xtrx-sdr/xtrx-adapters/PCIex2 frontend/Project Outputs/Pics/TOP_Full.png

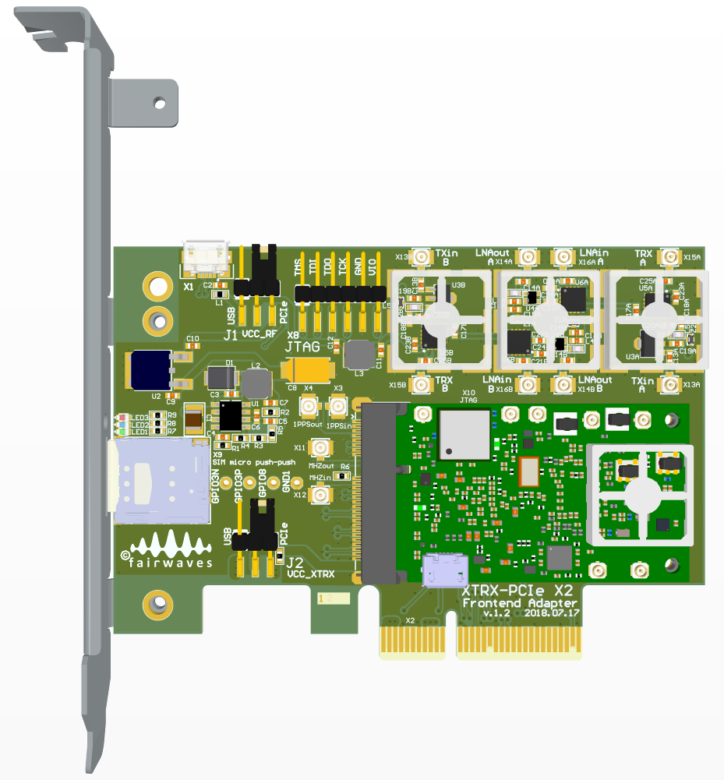
PCIex2 frontend/Project Outputs/Pics/TOP_Full.png
