xtrx-sdr/xtrx-adapters/README.md

* USB 3 Adapter with Aluminum Enclosure, v2.1
* PCIe x2 + Front End Adapter, v1.3
