xtrx-sdr/xtrx-adapters/PCIex2 frontend/Project Outputs/Pics/Layer Stack.png

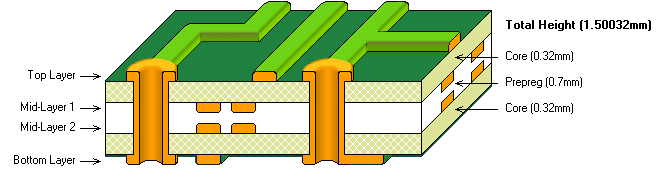
PCIex2 frontend/Project Outputs/Pics/Layer Stack.png
