xtrx-sdr/xtrx-adapters/PCIex2 frontend/Project Outputs/Pics/TOP_ISO_Full_XTRX-1.png

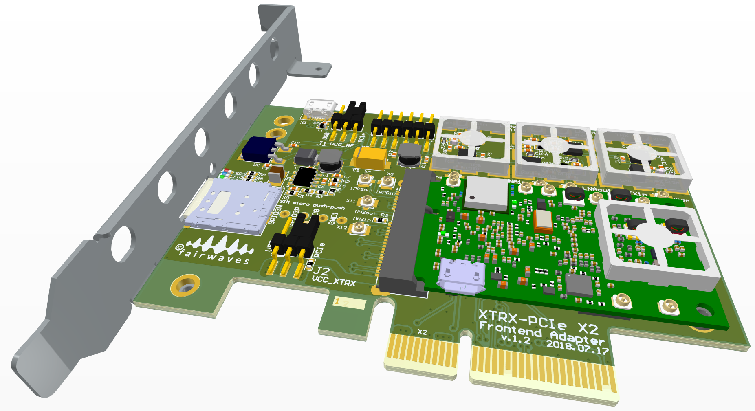
PCIex2 frontend/Project Outputs/Pics/TOP_ISO_Full_XTRX-1.png
