xtrx-sdr/xtrx-adapters/PCIex2 frontend/Project Outputs/Pics/TOP_ISO_Full_XTRX-2.png

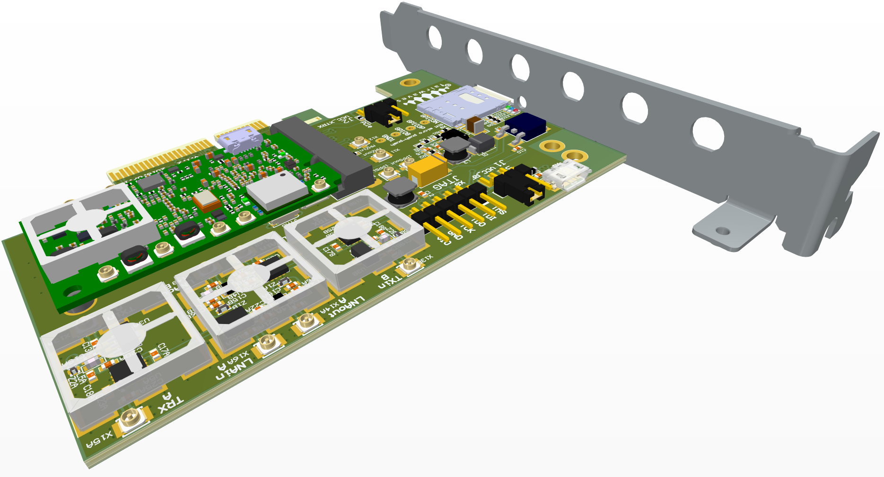
PCIex2 frontend/Project Outputs/Pics/TOP_ISO_Full_XTRX-2.png
