xtrx-sdr/xtrx-adapters/USB3/Models/frw 003 02.758.jpg

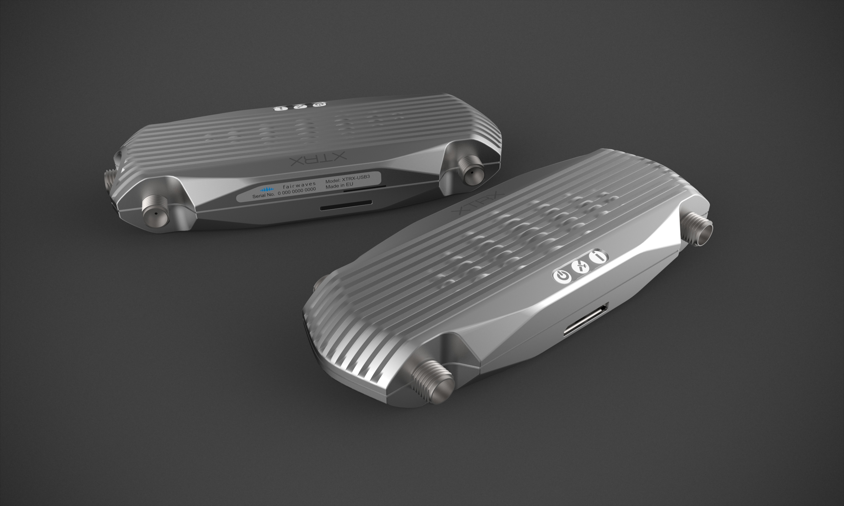
USB3/Models/frw 003 02.758.jpg
