xtrx-sdr/xtrx-adapters/USB3/Models/frw 003 Enclosure Prototype.png

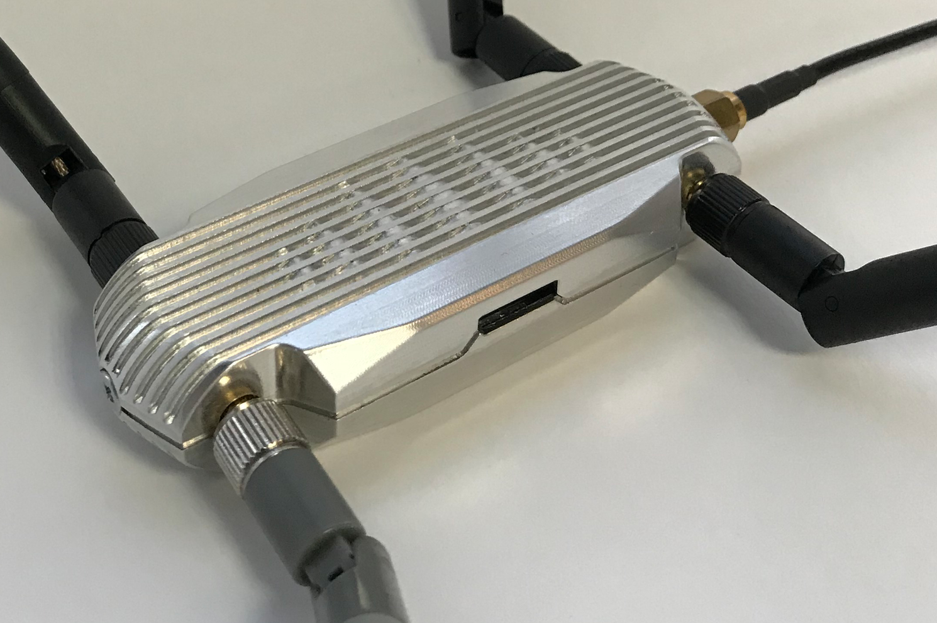
USB3/Models/frw 003 Enclosure Prototype.png
