xtrx-sdr/xtrx-adapters/USB3/Project Outputs/Pics/Enclosure base part.png

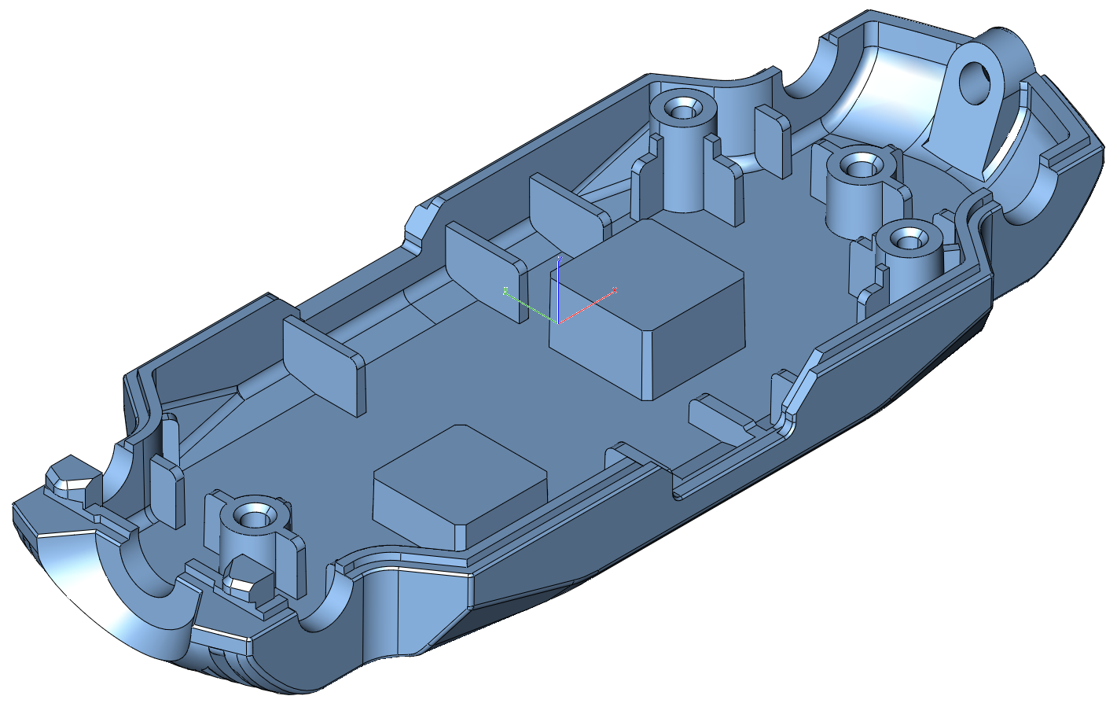
USB3/Project Outputs/Pics/Enclosure base part.png
