xtrx-sdr/xtrx-adapters/USB3/Project Outputs/Pics/Enclosure cover part.png

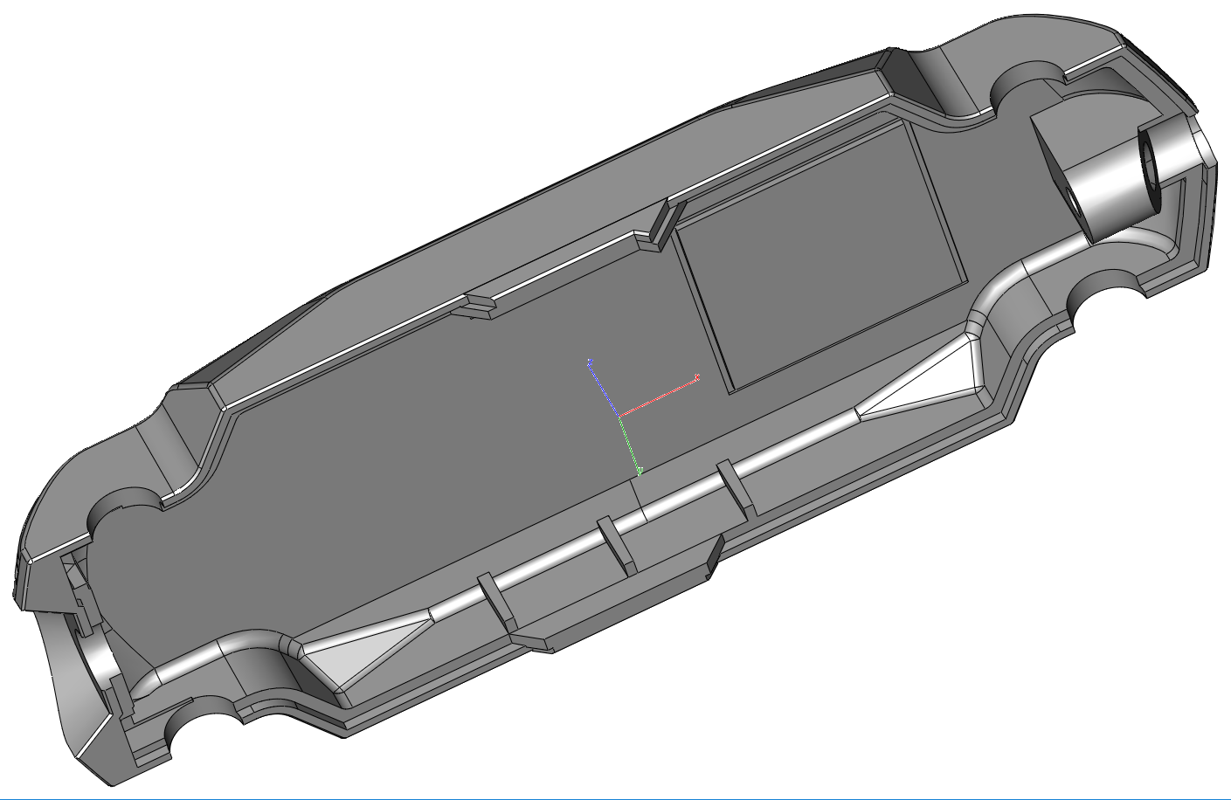
USB3/Project Outputs/Pics/Enclosure cover part.png
