xtrx-sdr/xtrx-adapters/USB3/Project Outputs/Pics/UFL-UFL cables connections.png

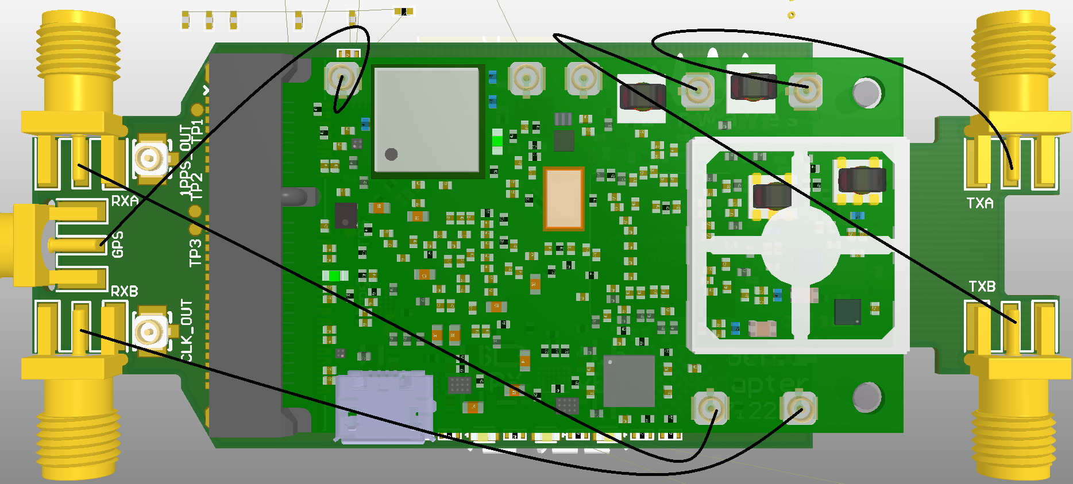
USB3/Project Outputs/Pics/UFL-UFL cables connections.png
