xtrx-sdr/xtrx-adapters/PCIex2 frontend/Project Outputs/BOM/Bill of Materials-x4to1XTRXv13(Fully eqpt).xls

Description | Comment | Value | U/P/TKE | Name | Designator | Footprint | Link | Manufacturer | Quantity
Cable jumper | AC-S01BH-U04RJ-F13-15 |  |  | AC-S01BH-U04RJ-F13-15 | CJ1, CJ2, CJ5A, CJ5B, CJ6A, CJ6B |  | https://rfsupplier.com/sma-female-to-ipex-ufl-connector-cable-with-rg113-cbale_p6418.html | RFSupplier | 6
Cable jumper | AC-U04RJ-U04RJ-F13-7.62 |  |  | AC-U04RJ-U04RJ-F13-7.62 | CJ3A, CJ3B, CJ4A, CJ4B |  | https://rfsupplier.com/customcable.html | RFSupplier | 4
Capacitor | 0.01uF | 0.01uF | X7R | SMD0603 | C4 | C0603-PHILLIPS |  | MURATA | 1
Capacitor | 0.1uF | 0.1uF | X7R | SMD0603 | C2, C3, C9, C10, C12, C15A, C15B, C18A, C18B | C0603-PHILLIPS |  | MURATA | 9
Capacitor | 10nF | 10nF | X7R | SMD0603 | C23A, C23B, C24A, C24B | C0603-PHILLIPS |  | MURATA | 4
Capacitor | 10uF | 10uF | X5R/16V | SMD0805 | C1 | C0805 | https://octopart.com/search?start=0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 | MURATA | 1
Capacitor | 10uF/6.3V | 10uF/6.3V | Y5V | SMD0603 | C11 | C0603-Phillips | https://octopart.com/search?q=0603+10uF+6.3v | MURATA | 1
Capacitor | 22uF/6.3V | 22uF/6.3V | X5R/6.3V | SMD0603 | C7 | C0603-PHILLIPS | https://octopart.com/grm188r60j226mea0d-murata-21407286 | MURATA | 1
Capacitor | 100pF | 100pF | NP0 | SMD0603 | C13A, C13B, C14A, C14B, C16A, C16B, C17A, C17B, C19A, C19B, C20A, C20B, C21A, C21B, C22A, C22B, C25A, C25B | C0603-PHILLIPS |  | MURATA | 18
Capacitor | 330uF/10V | 330uF/10V | 10V | CASE-D | C8 | cd7343 | https://octopart.com/search?q=330uF+10V+tantalum+D | Kemet | 1
CNC'ed enclosure component | Custom PCIe Bracket XTRX | FRW-002_PCIE_BRACKET_R5 |  | Custom PCIe Bracket XTRX | E3 | Custom_PCIe_bracket_XTRX1 | https://drive.google.com/drive/u/0/folders/1H4kDKzo1hdiNwqkA16l54XGZ7OmraAuD |  | 1
Coil | 2.2uH | 2.2uH | 2.9A/42mOhm | NRS5020T2R2NMGJ | L2 | L-NRS5030 | https://octopart.com/nrs5020t150mmgj-taiyo+yuden-13146350 | Taiyo Yuden | 1
Coil | 15uH | 15uH | 1.1A/165mOhm | NRS5020T150MMGJ | L3 | L-NRS5030 | https://octopart.com/nrs5020t150mmgj-taiyo+yuden-13146350 | Taiyo Yuden | 1
Coil | 22nH | 22nH |  | LQW18AN22NG00D | L4A, L4B, L5A, L5B | TF160808-Phillips | https://octopart.com/lqw18an22ng00d-murata-890271 | MuRata | 4
Connector (UMCC) | 0734120110 |  |  | 0734120110 | X3, X4, X11, X12, X13A, X13B, X14A, X14B, X15A, X15B, X16A, X16B | U_FL | https://octopart.com/0734120110-molex-16756629 | Molex | 12
Connector board to board | JTAG | JTAG |  | 78864-1001 | X10 | Molex 78864-1001 | https://octopart.com/78864-1001-molex-52668680?r=sp&s=CalIQCkHRmWKRIBINWJXJg | Molex | 1
Connector header male | TSM-106-01-T-SH | JTAG |  | TSM-106-01-T-SH | X8 | Head_Male_6P_R/A_SMD | https://octopart.com/tsm-106-01-t-sh-samtec-8444065?r=sp&s=4nKo29egTCGXCLlTpUf1dA | Samtec | 1
Connector microUSB-B | 105017-0001 | 105017-0001 |  | USB-microB | X1 | USB-micro-B | https://octopart.com/1050170001-molex-11866487?r=sp&s=Om3EEUYtRd-BHyhqotd9rA | MOLEX | 1
Connector PCIe MiniCard | PCIe MiniCard 1.55mm connector |  |  | MM60-52B1-G1 | X5 | PCIe MiniCard 1.55mm conn | https://octopart.com/mm60-52b1-g1-r850-jae+electronics-19499790 | JAE Electronics | 1
Connector SIM micro card | SIM micro push-push | SF56S006V4BR2000 |  |  | X9 | SIM_SF56S006V4BR2000-dig | https://octopart.com/sf56s006v4br2000-jae+electronics-55772495?r=sp&s=RZW5_ItfTZ2wF5MtOkXdLQ | JAE | 1
EMI Filter | KNH16C105DB5TS | 1uF/10V/2A |  | KNH16C105DB5TS | Z1A, Z1B, Z2A, Z2B | KNH16 - DB Serie | https://octopart.com/knh16c105db5ts-avx-21214733 | AVX / Kyocera | 4
Ferrite Bead EMIFIL | BLM18PG181SN1D |  | 180 Ohm, 90 mOhm,1.5A | BLM18PG181SN1D | L1 | TI160808-Phillips | https://octopart.com/blm18pg181sn1d-murata-755298?r=sp&s=UoqSqWT2SxaJq0Sn2mx1DQ | MURATA | 1
IC | SBB-5089 |  |  | SBB-5089 | U3A, U3B | SOT89 | https://octopart.com/search?r=sp&s=Om3EEUYtRd-BHyhqotd9rA&q=sbb5089z&oq=SBB5089&start=0 | RFMD | 2
IC | SPF-5043Z |  |  | SPF-5043Z | U4A, U4B | SOT-343[2X1.25] | https://octopart.com/search?q=SPF+5043Z | RFMD | 2
IC | TPS62130RG |  | 3-17V | TPS62130RG | U1 | QFN16(3x3/0/5mm)-Case485AE | https://octopart.com/search?q=tps62130rg | TI | 1
IC LDO fixed Vo | NCP5501DT50G |  | 5.0V/0.5A/3% | NCP5501DT50G | U2 | DPAK-3 | https://octopart.com/ncp5501dt50g-on+semiconductor-1008548?r=sp&s=uWahieJ2SIu9_CpFmEZfrA | ON Semi | 1
IC RF SPDT Absorptive Switch | SKY13286-359LF |  | 3-5V | SKY13286-359LF | U5A, U5B, U6A, U6B | QFN16(4x4/0.65mm) SQ | https://octopart.com/sky13286-359lf-skyworks+solutions-3998422 | Skyworks | 4
Jumper 3 pin | TSM-103-01-T-SH | FE Power Select, XTRX Power Select |  | TSM-103-01-T-SH | J1, J2 | Head_Male_3P_R/A_SMD | https://octopart.com/tsm-103-01-t-sh-samtec-8024795?r=sp&s=QwI2rG3eQKmfzGqx_DrZCQ | Samtec | 2
Jumper Short Cup | CYT1058 |  |  | CYT1058 | J1', J2' |  | https://www.amazon.com/dp/B06X1FFLMR |  | 2
LED BLUE | LTST-C190TBKT | BLUE | 100mcd, 3.3V/20mA, -20+80°C | LTST-C190TBKT | LED2 | LED-0603BL | http://www.digikey.com/product-detail/en/LTST-C190TBKT/160-1646-1-ND/573586 | Lite-On Inc | 1
LED GREEN | LTST-C190KGKT | GREEN | 40mcd, 2V/20mA, -30+85°C | LTST-C190KGKT | LED1 | LED-0603GR | https://octopart.com/ltst-c190kgkt-lite-on-549897 | Lite-On Inc | 1
LED RED | LTST-C190KRKT | RED | 100mcd, 2V/20mA, -30+85°C | LTST-C190KRKT | LED3 | LED-0603RD | http://www.digikey.com/product-detail/en/LTST-C190KRKT/160-1436-1-ND/386816 | Lite-On Inc | 1
Resistor | 1k | 1k | 0.1W | SMD0603 | R6 | R0603-PHILLIPS |  | YAGEO | 1
Resistor | 2k | 2k | 0.1W | SMD0603 | R4 | R0603-PHILLIPS |  | YAGEO | 1
Resistor | 12k | 12k | 0.1W | SMD0603 | R5 | R0603-PHILLIPS |  | YAGEO | 1
Resistor | 330 | 330 | 0.1W | SMD0603 | R7, R8, R9 | R0603-PHILLIPS |  | YAGEO | 3
Screening shield cover | Screening shield cover BMI-S-202-C |  |  | Screening shield cover BMI-S-202-C | Cover1, Cover2, Cover3 |  | https://octopart.com/bmi-s-202-c-laird-19008953 | Laird Tech | 3
Screening shield frame | Screening shield frame BMI-S-202-F |  |  | Screening shield frame BMI-S-202-F | Shield1, Shield2, Shield3 | BMI-S-202-F | https://octopart.com/bmi-s-202-f-laird-19008954 | Laird Tech | 3
Screw #4-40 | AFBST090-440X532-000200 |  |  | AFBST090-440X532-000200 | E4, E5 |  | https://www.amazon.com/dp/B019EEPRJQ/ref=cm_sw_r_cp_ep_dp_erIuBbK2SDENX | Aspen Fasteners | 2
Screw M2 | ASMM19228 |  |  | ASMM19228 | E1, E2 |  | https://www.amazon.com/dp/B00BNCAFR2/ref=cm_sw_r_cp_ep_dp_pCFuBbPAM8QH4 | Aspen Fasteners | 2
Stand-off nut PCIe MiniCard | NT1R3000 |  |  | NT1R3000 | X6, X7 | PCIe MiniCard 1.55mm stand off nut | https://octopart.com/nt1r3000-jae+electronics-19043816 | JAE Electronics | 2
Thermal gap filler | A piece of 15x30mm applied under XTRX | A piece of 15x30mm applied under XTRX |  | PL-05-5-1016-H | TG1 |  | https://octopart.com/pl-05-5-1016-h-wakefield-80458840 | Wakefield | 1
