xtrx-sdr/xtrx-adapters/USB3/Project Outputs/BOM/Bill of Materials-USB3-PCIEv21(Var_1).xls

Description | Comment | Value | U/P/TKE | Name | Designator | Footprint | Link | Manufacturer | Quantity
Cable jumper | AC-U04RJ-U04RJ-F13-7.62 |  |  | AC-U04RJ-U04RJ-F13-7.62 | CJ1, CJ2, CJ3, CJ4, CJ5 |  | https://rfsupplier.com/customcable.html | RFSupplier | 5
Capacitor | 0.01uF | 0.01uF | X7R/10V | SMD0402 | C9, C19, C23, C25, C30, C31, C37, C38, C46 | C0402-Phillips | https://octopart.com/search?q=CC0402%2010000pF%20X7R&start=0 | YAGEO | 9
Capacitor | 0.1uF | 0.1uF | X5R/25V | SMD0402 | C2, C3, C5, C6, C7, C8, C14, C16, C17, C18, C21, C22, C24, C27, C28, C29, C33, C35, C36, C39, C43 | C0402-Phillips | http://www.digikey.com/product-detail/en/CC0402KRX5R7BB104/311-1347-1-ND/2103131 | YAGEO | 21
Capacitor | 1uF | 1uF | X5R/10V | SMD0402 | C15, C26, C32, C41, C44 | C0402-Phillips | https://octopart.com/grm155r61a105ke15d-murata-197442 | MuRata | 5
Capacitor | 10uF | 10uF | X5R/6.3V | SMD0402 | C1, C12, C13, C34, C40, C42, C47, C48, C49, C50, C51, C52 | C0402-Phillips | https://octopart.com/search?q=0402%2010uF%206.3V&start=0 | MuRata | 12
Capacitor | 18pF | 18pF | C0G/10V | SMD0402 | C10, C11 | C0402-Phillips | https://octopart.com/search?q=CC0402%2018pF%20C0G%205%25&start=0 | Yageo | 2
Capacitor | 1000pF | 1000pF | X7R/50V | SMD0402 | C20, C45 | C0402-Phillips | http://www.digikey.com/product-detail/en/GRM155R71H102KA01D/490-1303-2-ND/587225 | MuRata | 2
Coil | 0.47uH | 0.47uH | 2.8A/35mOhm | VLS201610HBX-R47M-1 | L3, L4, L5, L6 | L-VLS201610HBX | https://octopart.com/vls201610hbx-r47m-1-tdk-52458594 | TDK | 4
Connector (UMCC) | 0734120110 |  |  | 0734120110 | X3, X7, X9, X10, X11, X12, X13 | U_FL | https://octopart.com/0734120110-molex-16756629 | Molex | 7
Connector board to board | XTRX-JTAG | XTRX-JTAG |  | 78864-1001 | X8 | Molex 78864-1001 | https://octopart.com/78864-1001-molex-52668680?r=sp&s=CalIQCkHRmWKRIBINWJXJg | Molex | 1
Connector coaxial | SMA edge SMD mount | S01-SJEDM-11BS00 |  | SMA edge SMD mount | X14, X15, X16, X17, X18 | SMA - edge | https://rfsupplier.com/sma-jack-female-connector-straight-solder_p3413.html | RFSupplier | 5
Connector microUSB3.0-Type B | 692622030100 | 692622030100 |  | USB3.0-MicroB | X1 | USB3.0-MicroB SMT | https://octopart.com/692622030100-w%C3%BCrth+elektronik-19667821 | Wurth | 1
Connector PCIe MiniCard 1.55mm | Connector PCIe MiniCard 1.55mm | XTRX Connector |  | MM60-52B1-G1 | X5 | PCIe MiniCard 1.55mm conn | https://octopart.com/mm60-52b1-g1-r850-jae+electronics-19499790 | JAE Electronics | 1
Connector SIM card | Connector SIM card |  |  | SF56S006V4BR2000 | X6 | SIM_SF56S006V4BR2000-dig | https://octopart.com/sf56s006v4br2000-jae+electronics-55772495 | JAE | 1
Custom die cast enclosure | Base part FRW-003_Body_V11 |  |  | Base part FRW-003_Body_V11 | E2 |  | https://drive.google.com/drive/u/0/folders/1I-mi6vT2nCMv3PGihUKQUKjrt9PQ-9GC |  | 1
Custom die cast enclosure | Cover part FRW-003_Cover_V11 |  |  | Cover part FRW-003_Cover_V11 | E1 |  | https://drive.google.com/drive/u/0/folders/1I-mi6vT2nCMv3PGihUKQUKjrt9PQ-9GC |  | 1
EMI ferrite bead | BLM18SG221TN1 | 220 | 2.5A/40mOhm | BLM18SG221TN1 | L2 | TI160808-Phillips | https://octopart.com/blm18sg221tn1d-murata-7742616 | MURATA | 1
IC | USB3380-AB50NI G |  |  | USB3380-AB50NI G | U3 | QFN-88(10x10/0.4mm)_pad | https://octopart.com/usb3380-ab50ni+g-avago-51854480 | PLX Tech | 1
IC dual 2A step down DCDC | MIC23158YML |  | 2.7-5.5V to 1.0-3.3V/2A | MIC23158YML | U4 | MLF-20(3X4/0.5)MIC | https://octopart.com/mic23158yml-t5-microchip-66800781?r=sp&s=2B-5sdHiQDiFSNDW-gVygQ | MIcrochip | 1
IC SPI CMOS EEPROM | CAT25640YI-G | 64kbit |  | CAT25640YI-G | U2 | TSSOP-8 | https://octopart.com/cat25640yi-g-on+semiconductor-13132660?r=sp&s=sj-Wom8UQsSSkL3DnHra1A | ON Semi | 1
LED WHITE | WHITE | WHITE | 100mcd, 2.7V/5mA, -30+85°C | LTW-C190DA5 | LED1, LED2, LED3 | LED-0603YL | https://octopart.com/ltw-c190da5-lite-on-20324489?r=sp&s=07WAyZa6SYa5jtmHD_gN_Q | Lite-On Inc | 3
Quartz crystall SMD | 30.0MHz | 30.0MHz | -40+85C/<100ppm | ABM8G-30.000MHZ-18-D2Y-T | Z1 | ZQ_SMD2532 | https://octopart.com/abm8g-30.000mhz-18-d2y-t-abracon-12676610 | Abracon | 1
Resistor | 0 | 0 | 50V/60mW/200ppm | CR0402-JW | R24, R28, R29, R30, R31, R32 | R0402-Phillips |  | BOURNS | 6
Resistor | 1k6 1% | 1k6 1% | 50V/60mW/200ppm | CR0402-JW | R23 | R0402-Phillips |  | BOURNS | 1
Resistor | 2k | 2k | 50V/60mW/200ppm | CR0402-JW | R25 | R0402-Phillips |  | BOURNS | 1
Resistor | 10k | 10k | 50V/60mW/200ppm | CR0402-JW | R13, R14, R15, R16, R17, R18, R19, R20, R21, R22, R39, R40, R41 | R0402-Phillips |  | BOURNS | 13
Resistor | 24k | 24k | 50V/60mW/200ppm | CR0402-JW | R6 | R0402-Phillips |  | BOURNS | 1
Resistor | 27k | 27k | 50V/60mW/200ppm | CR0402-JW | R34 | R0402-Phillips |  | BOURNS | 1
Resistor | 33 | 33 | 50V/60mW/200ppm | CR0402-JW | R26, R27 | R0402-Phillips |  | BOURNS | 2
Resistor | 47k | 47k | 50V/60mW/200ppm | CR0402-JW | R7 | R0402-Phillips |  | BOURNS | 1
Resistor | 120k | 120k | 50V/60mW/200ppm | CR0402-JW | R33, R35, R36, R37 | R0402-Phillips |  | BOURNS | 4
Resistor | 180k | 180k | 50V/60mW/200ppm | CR0402-JW | R38 | R0402-Phillips |  | BOURNS | 1
Resistor | 330 | 330 | 50V/60mW/200ppm | CR0402-JW | R8, R9, R10 | R0402-Phillips |  | BOURNS | 3
Screw M2 | DIN7985 A2 M2x4 | ASMM19228 |  | DIN7985 A2 M2x4 | E4, E5 |  | https://www.amazon.com/dp/B00BNCAFR2/ref=cm_sw_r_cp_ep_dp_pCFuBbPAM8QH4 | Aspen Fasteners | 2
Screw M2.5 | DIN7985 A2 M2.5x4 | ASMM19219 |  | DIN7985 A2 M2.5x4 | E6, E7 |  | https://www.amazon.com/dp/B00BNC9YEM/ref=cm_sw_r_cp_ep_dp_pIFuBbHC3NF0M | Aspen Fasteners | 2
Screw M3 | DIN965 A2 M3x8 | ASMM31490 |  | DIN965 A2 M3x8 | E3 |  | https://www.amazon.com/dp/B00BNCMRG4/ref=cm_sw_r_cp_ep_dp_6NDuBbRX0ZEC2 | Aspen Fasteners | 1
Thermal gap filler | 3 pcs of 10x10mm applied on Enclosure | 3 pcs of 10x10mm applied on Enclosure |  | PL-05-5-1016-H | TG1 |  | https://octopart.com/pl-05-5-1016-h-wakefield-80458840 | Wakefield | 1
