xtrx-sdr/xtrx-adapters/PCIex2 frontend/Models/PCIe 1XTRX v11 Full Height Bracket w holes rev5.stp

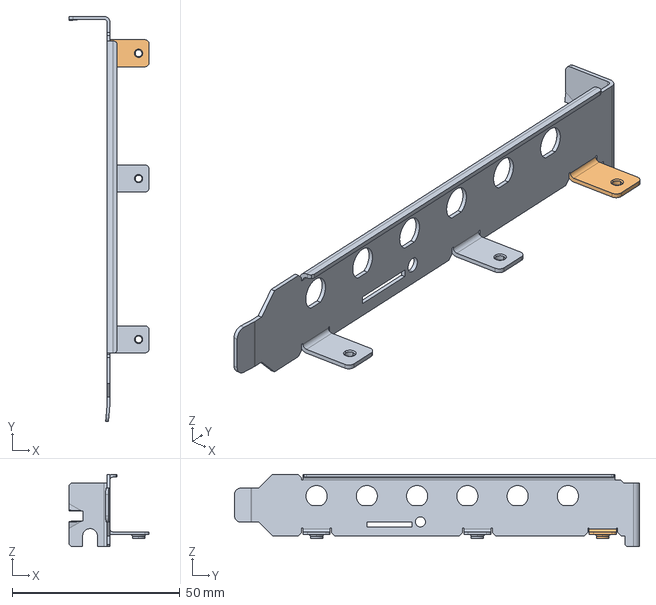
[picture p14: CAD file, 2022-04-05]
PCIex2 frontend/Models/PCIe 1XTRX v11 Full Height Bracket w holes rev5.stp
24.0 x 120.9 x 21.6 mm
