xtrx-sdr/xtrx-adapters/USB3/Models/Seal.stp

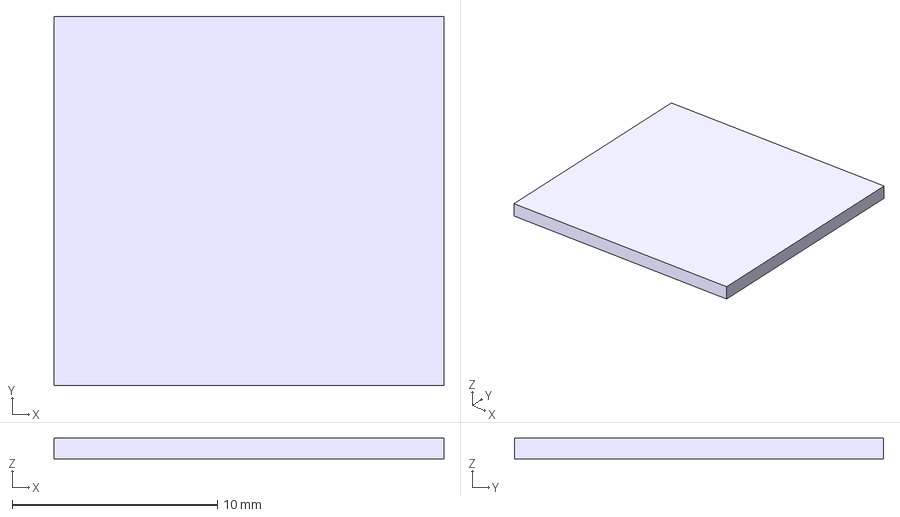
[picture p15: CAD file, 2022-04-05]
USB3/Models/Seal.stp
19.0 x 18.0 x 1.00 mm
