xtrx-sdr/xtrx-adapters/USB3/Models/XTRX bottom part.stp

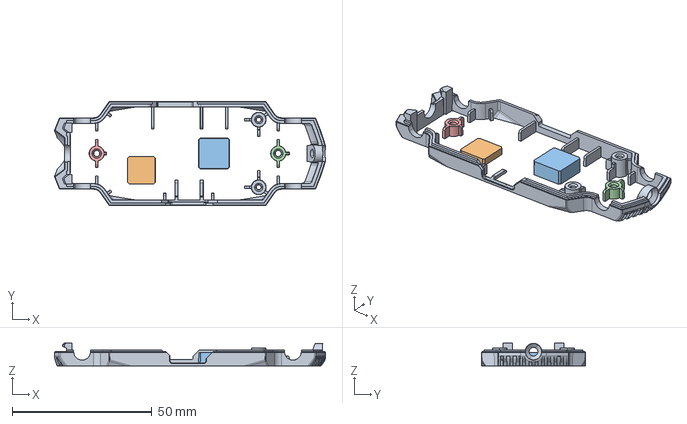
[picture p16: CAD file, 2022-04-05]
USB3/Models/XTRX bottom part.stp
97.0 x 37.4 x 8.20 mm
