xtrx-sdr/xtrx-adapters/USB3/Models/XTRX Cover part.stp

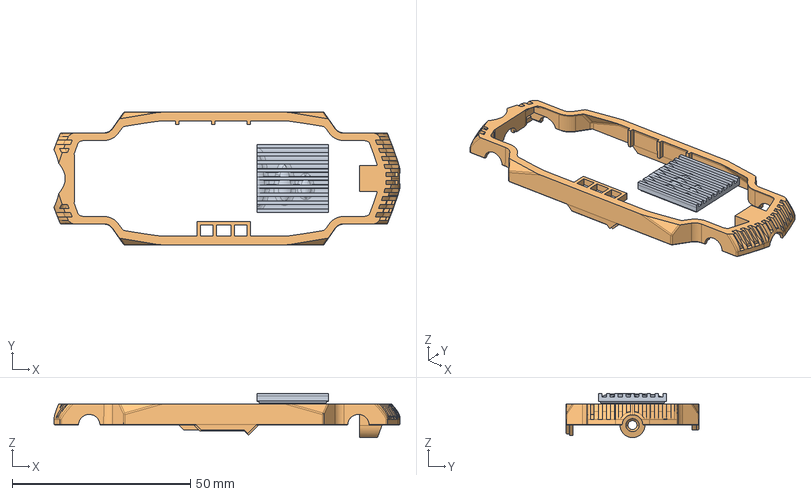
[picture p17: CAD file, 2022-04-05]
USB3/Models/XTRX Cover part.stp
97.0 x 37.4 x 12.4 mm
