xtrx-sdr/xtrx-adapters/PCIex2 frontend/Models/PCIe 1XTRX v11 Full Height Bracket w holes rev5.pdf

.86 *
#4-40, 3X

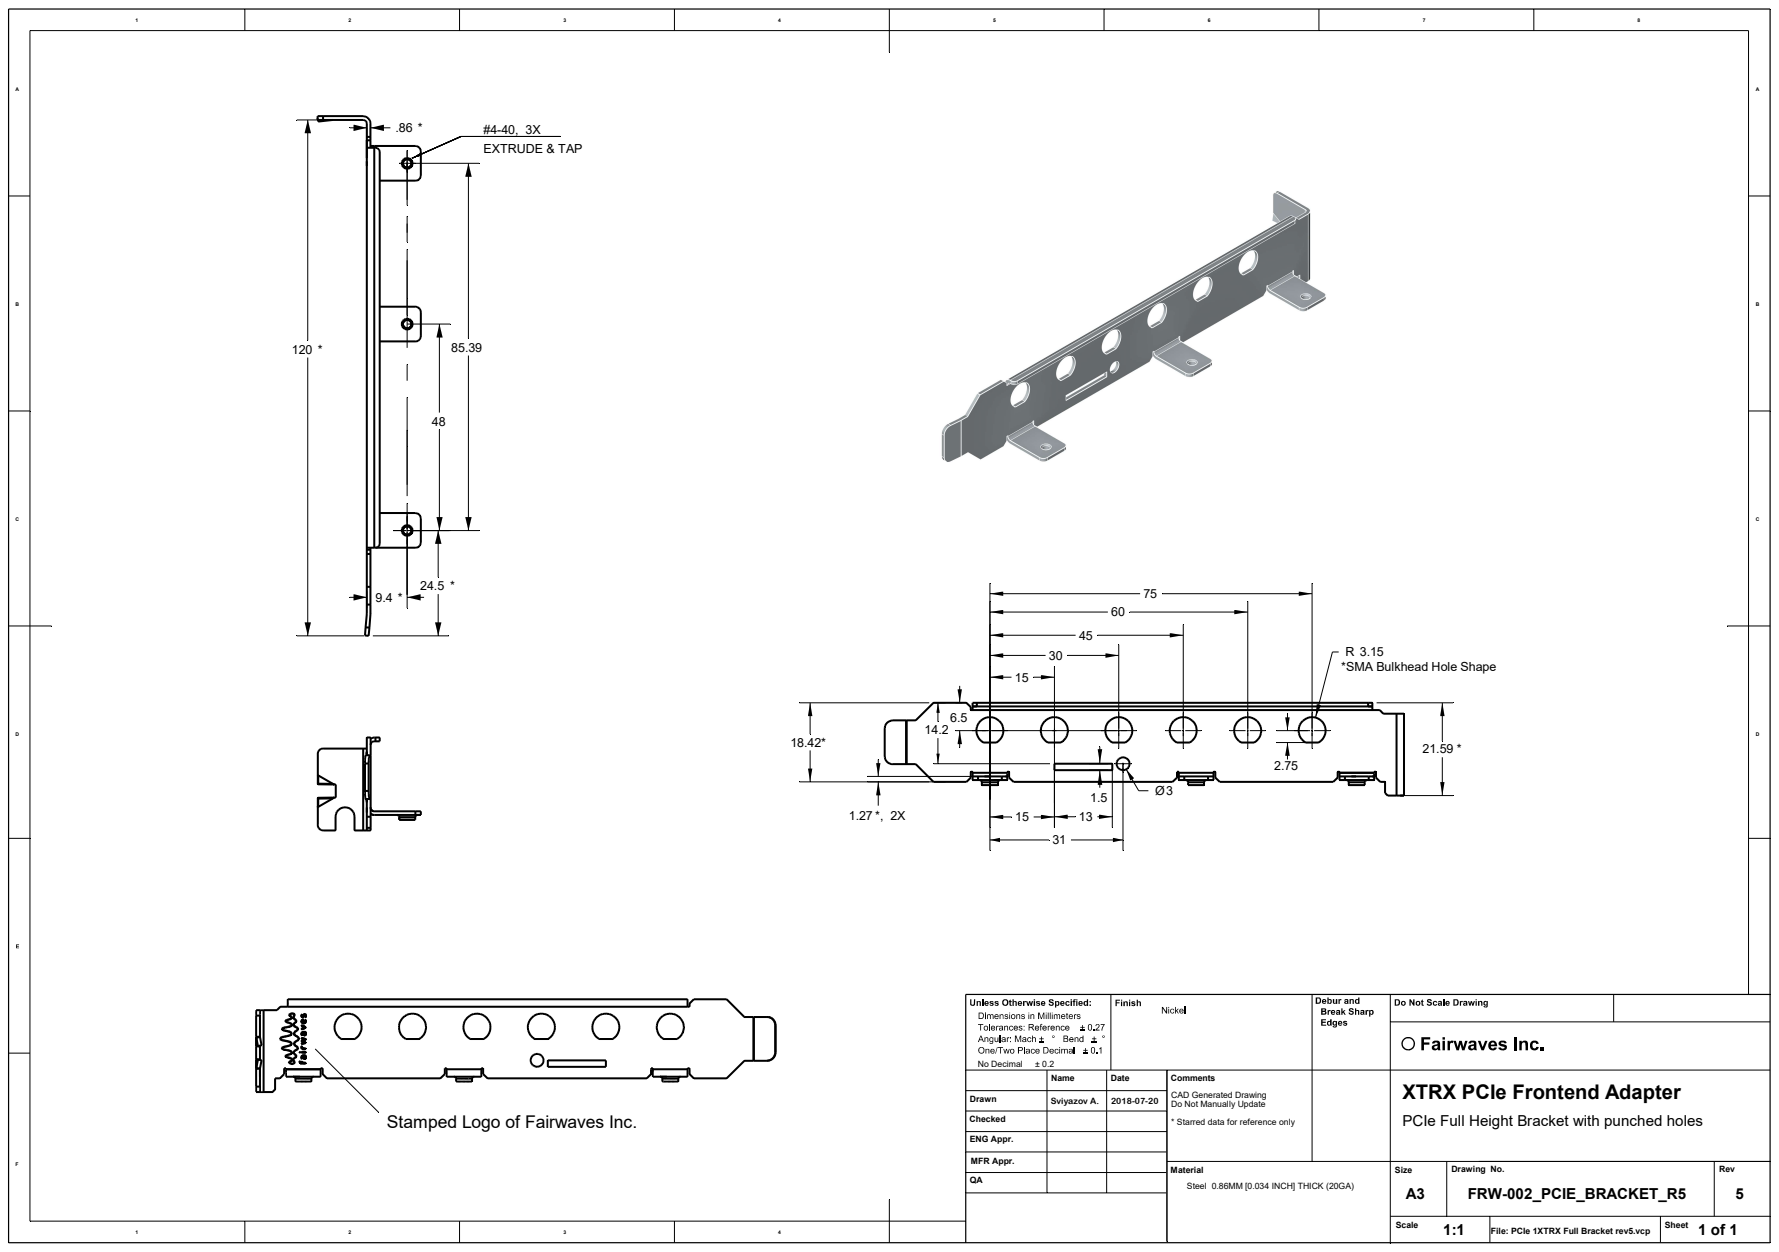
[picture p18: page 1]
EXTRUDE & TAP

*SMA Bulkhead Hole Shape

No Decimal ± 0.2

Name | Date | Comments CAD Generated Drawing Do Not Manually Update * Starred data for reference only | XTRX PCIe Frontend Adapter PCIe Full Height Bracket with punched holes

Drawn | Sviyazov A. | 2018-07-20

Stamped Logo of Fairwaves Inc.

Checked

ENG Appr.

MFR Appr.
QA

Material Steel 0.86MM [0.034 INCH] THICK (20GA) | Size A3 | Drawing No. FRW-002_PCIE_BRACKET_R5 | Rev 5

Scale 1:1 | File: PCIe 1XTRX Full Bracket rev5.vcp | Sheet 1 of 1
