xtrx-sdr/xtrx-adapters/PCIex2 frontend/Project Outputs/x4to1XTRXv13_drawing.PDF

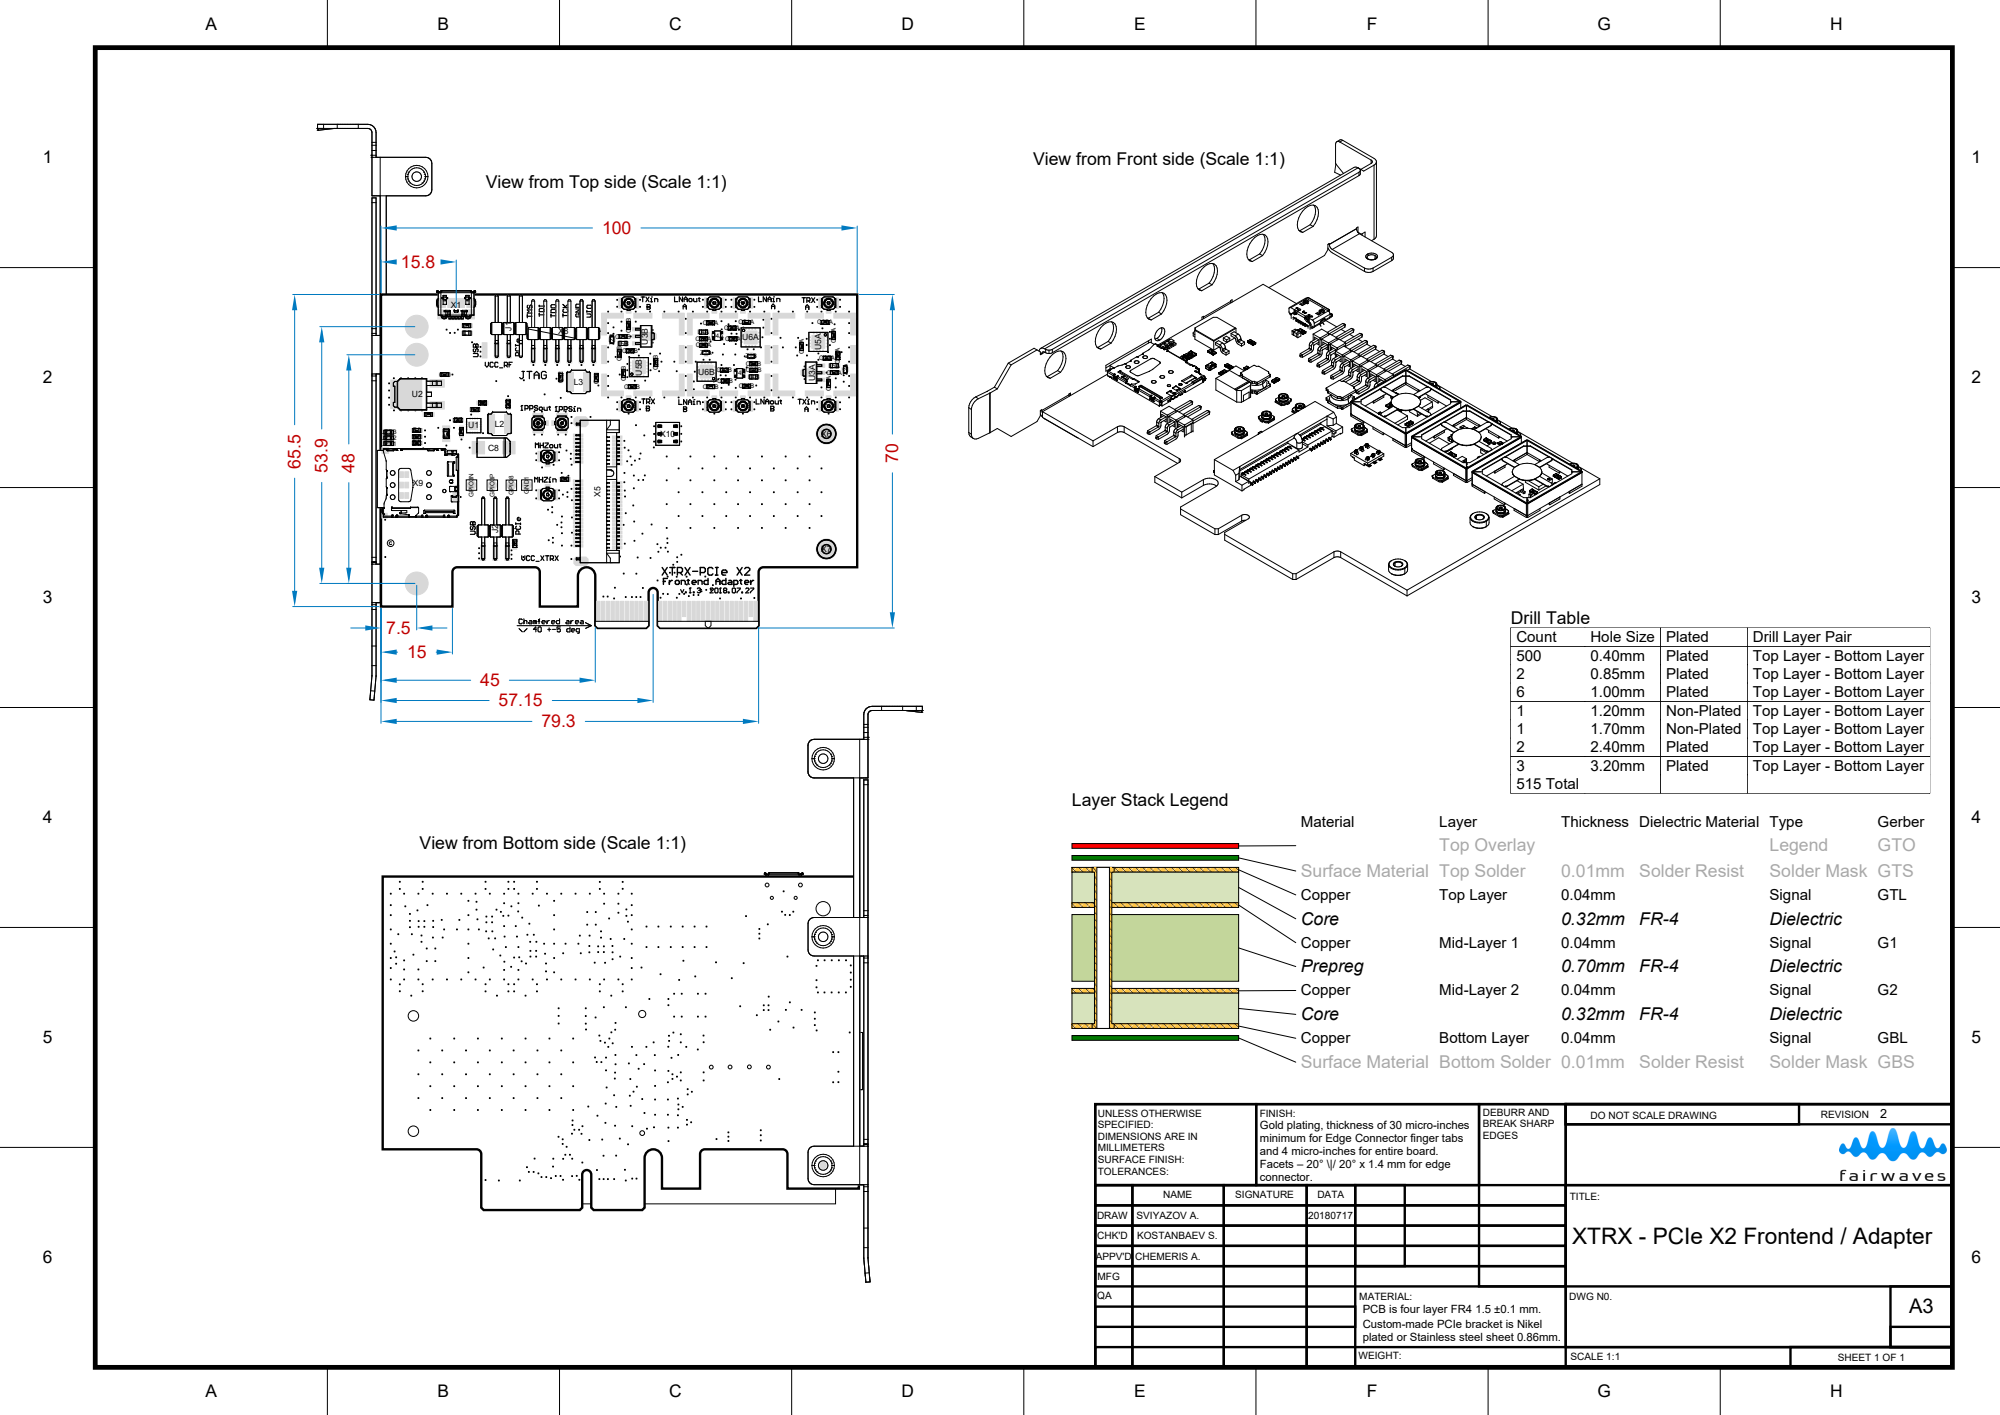
[picture p19: page 1]

View from Front side (Scale 1:1)

View from Top side (Scale 1:1)

Drill Layer Pair
Top Layer - Bottom Layer

View from Bottom side (Scale 1:1)

Gold plating, thickness of 30 micro-inches
minimum for Edge Connector finger tabs
and 4 micro-inches for entire board.
Facets – 20° \|/ 20° x 1.4 mm for edge
connector.

NAME | SIGNATURE | DATA | | | | TITLE: XTRX - PCIe X2 Frontend / Adapter

DRAW | SVIYAZOV A. | | 20180717
CHK'D | KOSTANBAEV S.

APPV'D | CHEMERIS A.
MFG
QA | | | | MATERIAL: PCB is four layer FR4 1.5 ±0.1 mm. Custom-made PCIe bracket is Nikel plated or Stainless steel sheet 0.86mm. | DWG N0. | A3
