xtrx-sdr/xtrx-adapters/PCIex2 frontend/Project Outputs/x4to1XTRXv13_Full_SCH.pdf

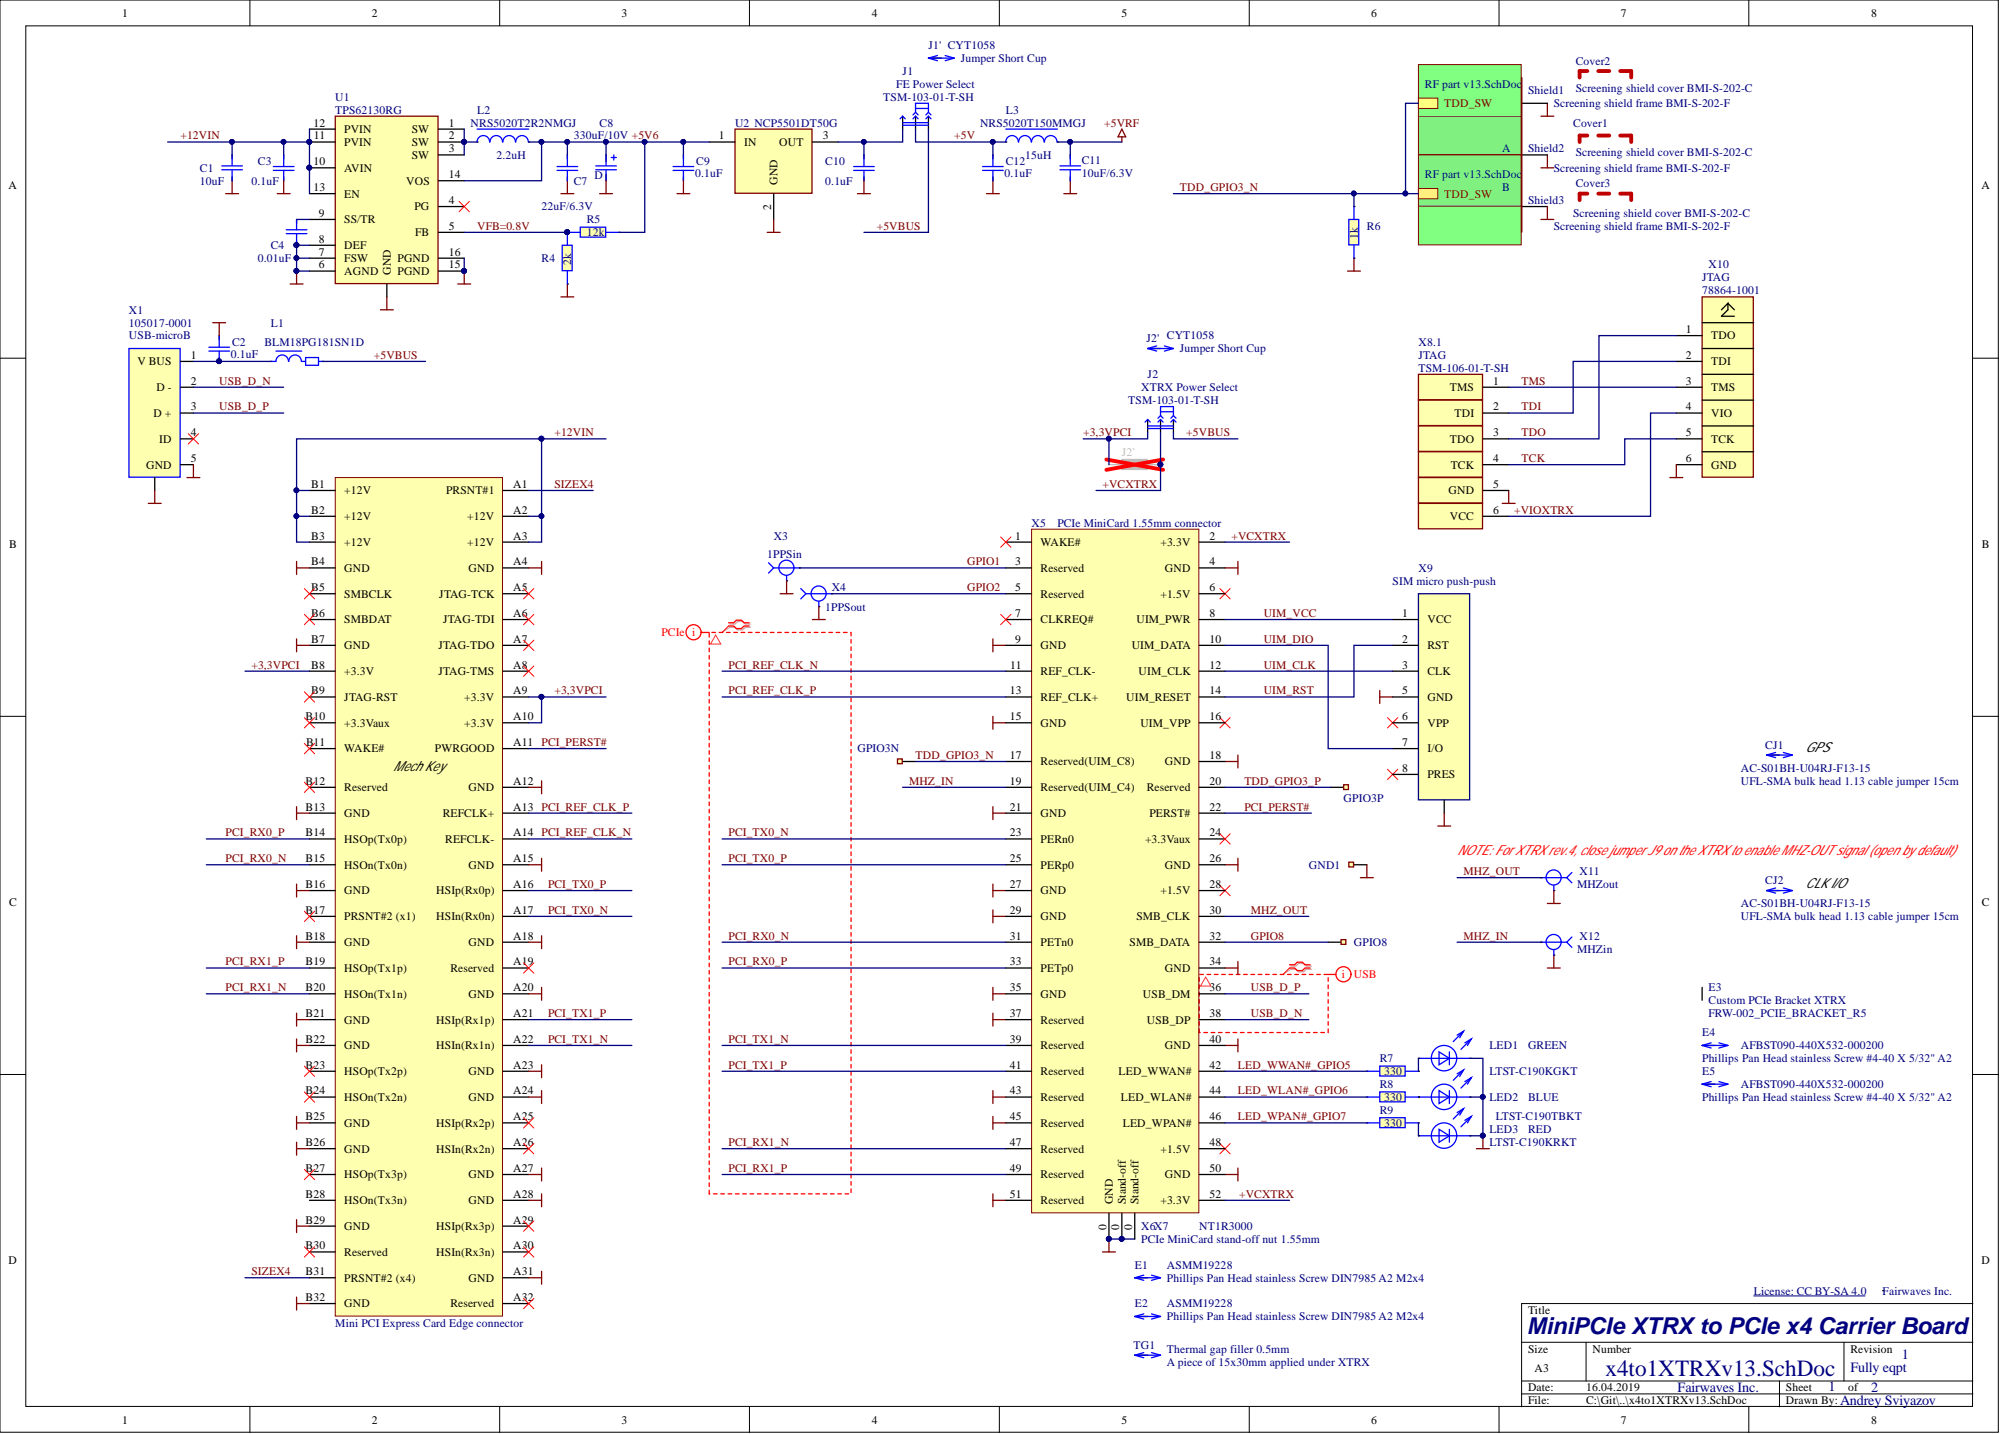
[picture p20: page 1]

Screening shield cover BMI-S-202-C
Screening shield frame BMI-S-202-F
Cover1

SIM micro push-push

UFL-SMA bulk head 1.13 cable jumper 15cm

NOTE: For XTRX rev.4, close jumper J9 on the XTRX to enable MHZ-OUT signal (open by default)

Phillips Pan Head stainless Screw #4-40 X 5/32" A2

PCIe MiniCard stand-off nut 1.55mm

Phillips Pan Head stainless Screw DIN7985 A2 M2x4

License: CC BY-SA 4.0 (https://creativecommons.org/licenses/by-sa/4.0/)

Title
MiniPCIe XTRX to PCIe x4 Carrier Board

Mini PCI Express Card Edge connector

A piece of 15x30mm applied under XTRX

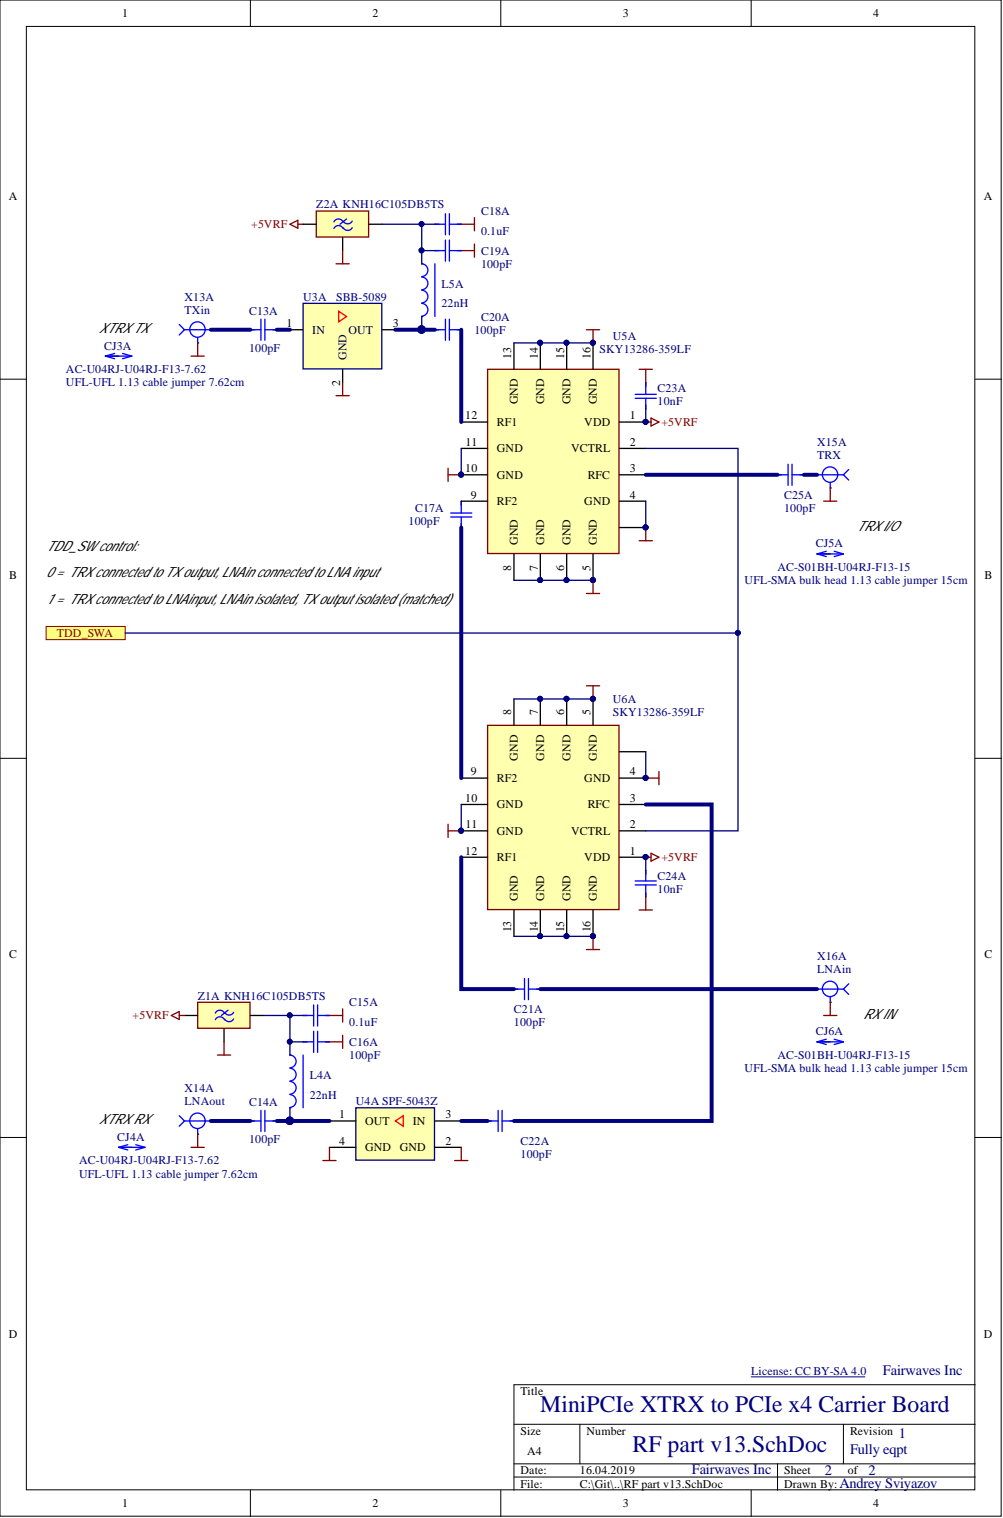
[picture p21: page 2]

UFL-UFL 1.13 cable jumper 7.62cm

UFL-SMA bulk head 1.13 cable jumper 15cm

1 = TRX connected to LNAinput, LNAin isolated, TX output isolated (matched)

0 = TRX connected to TX output, LNAin connected to LNA input

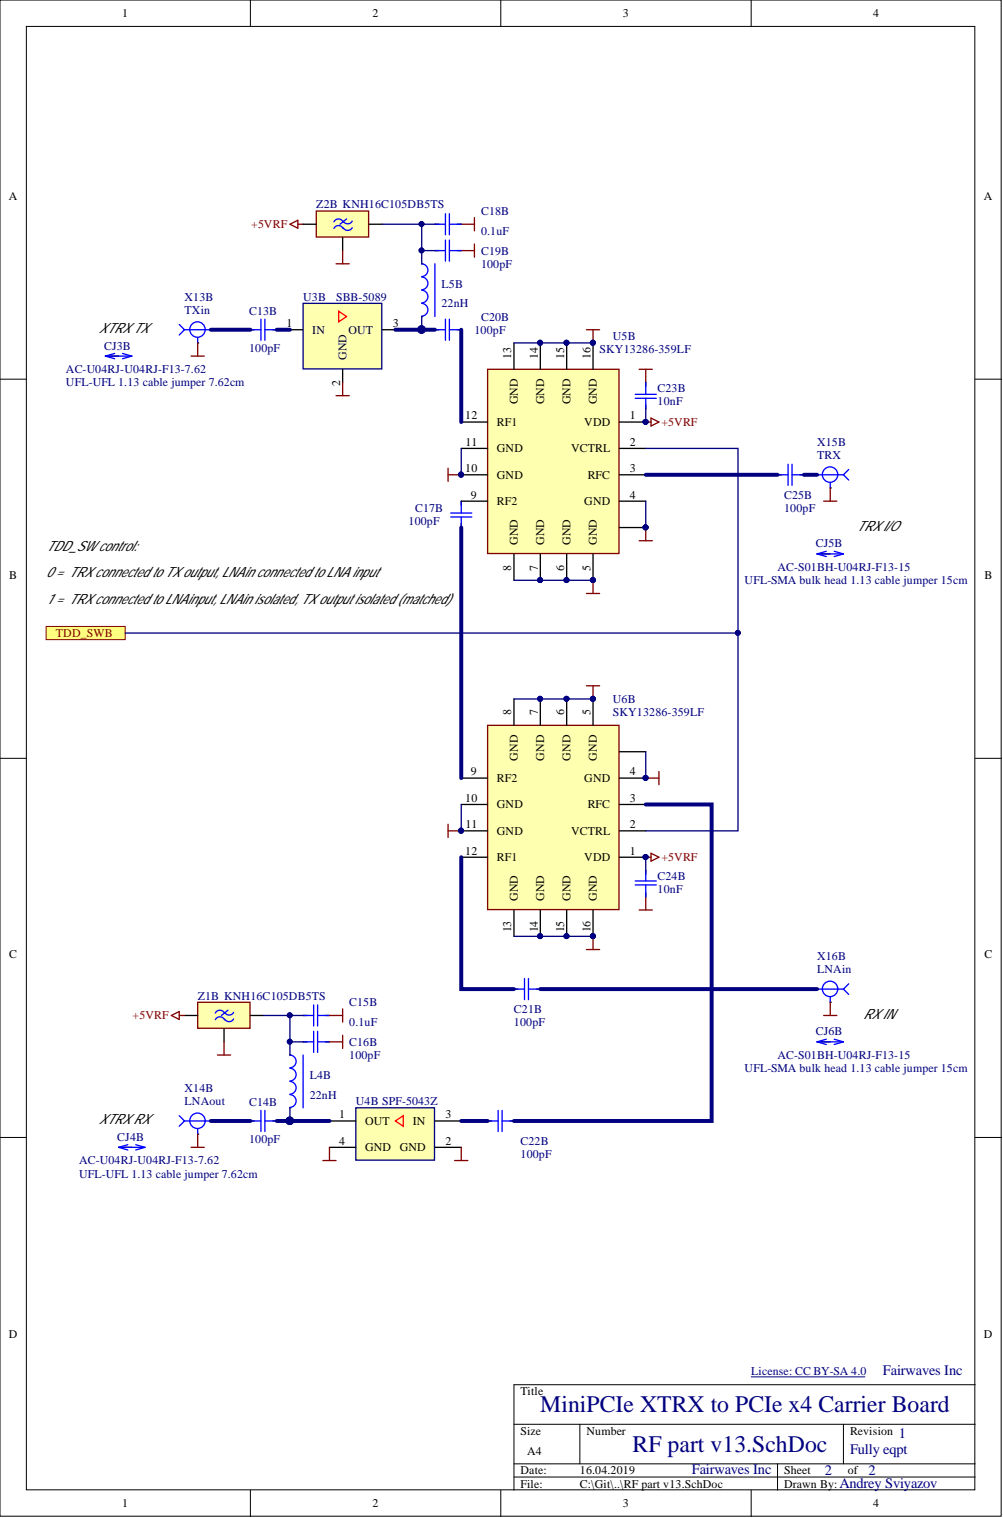
[picture p22: page 3]

UFL-UFL 1.13 cable jumper 7.62cm

UFL-SMA bulk head 1.13 cable jumper 15cm

1 = TRX connected to LNAinput, LNAin isolated, TX output isolated (matched)

0 = TRX connected to TX output, LNAin connected to LNA input
