xtrx-sdr/xtrx-adapters/PCIex2 frontend/Project Outputs/x4to1XTRXv13_assembly.PDF

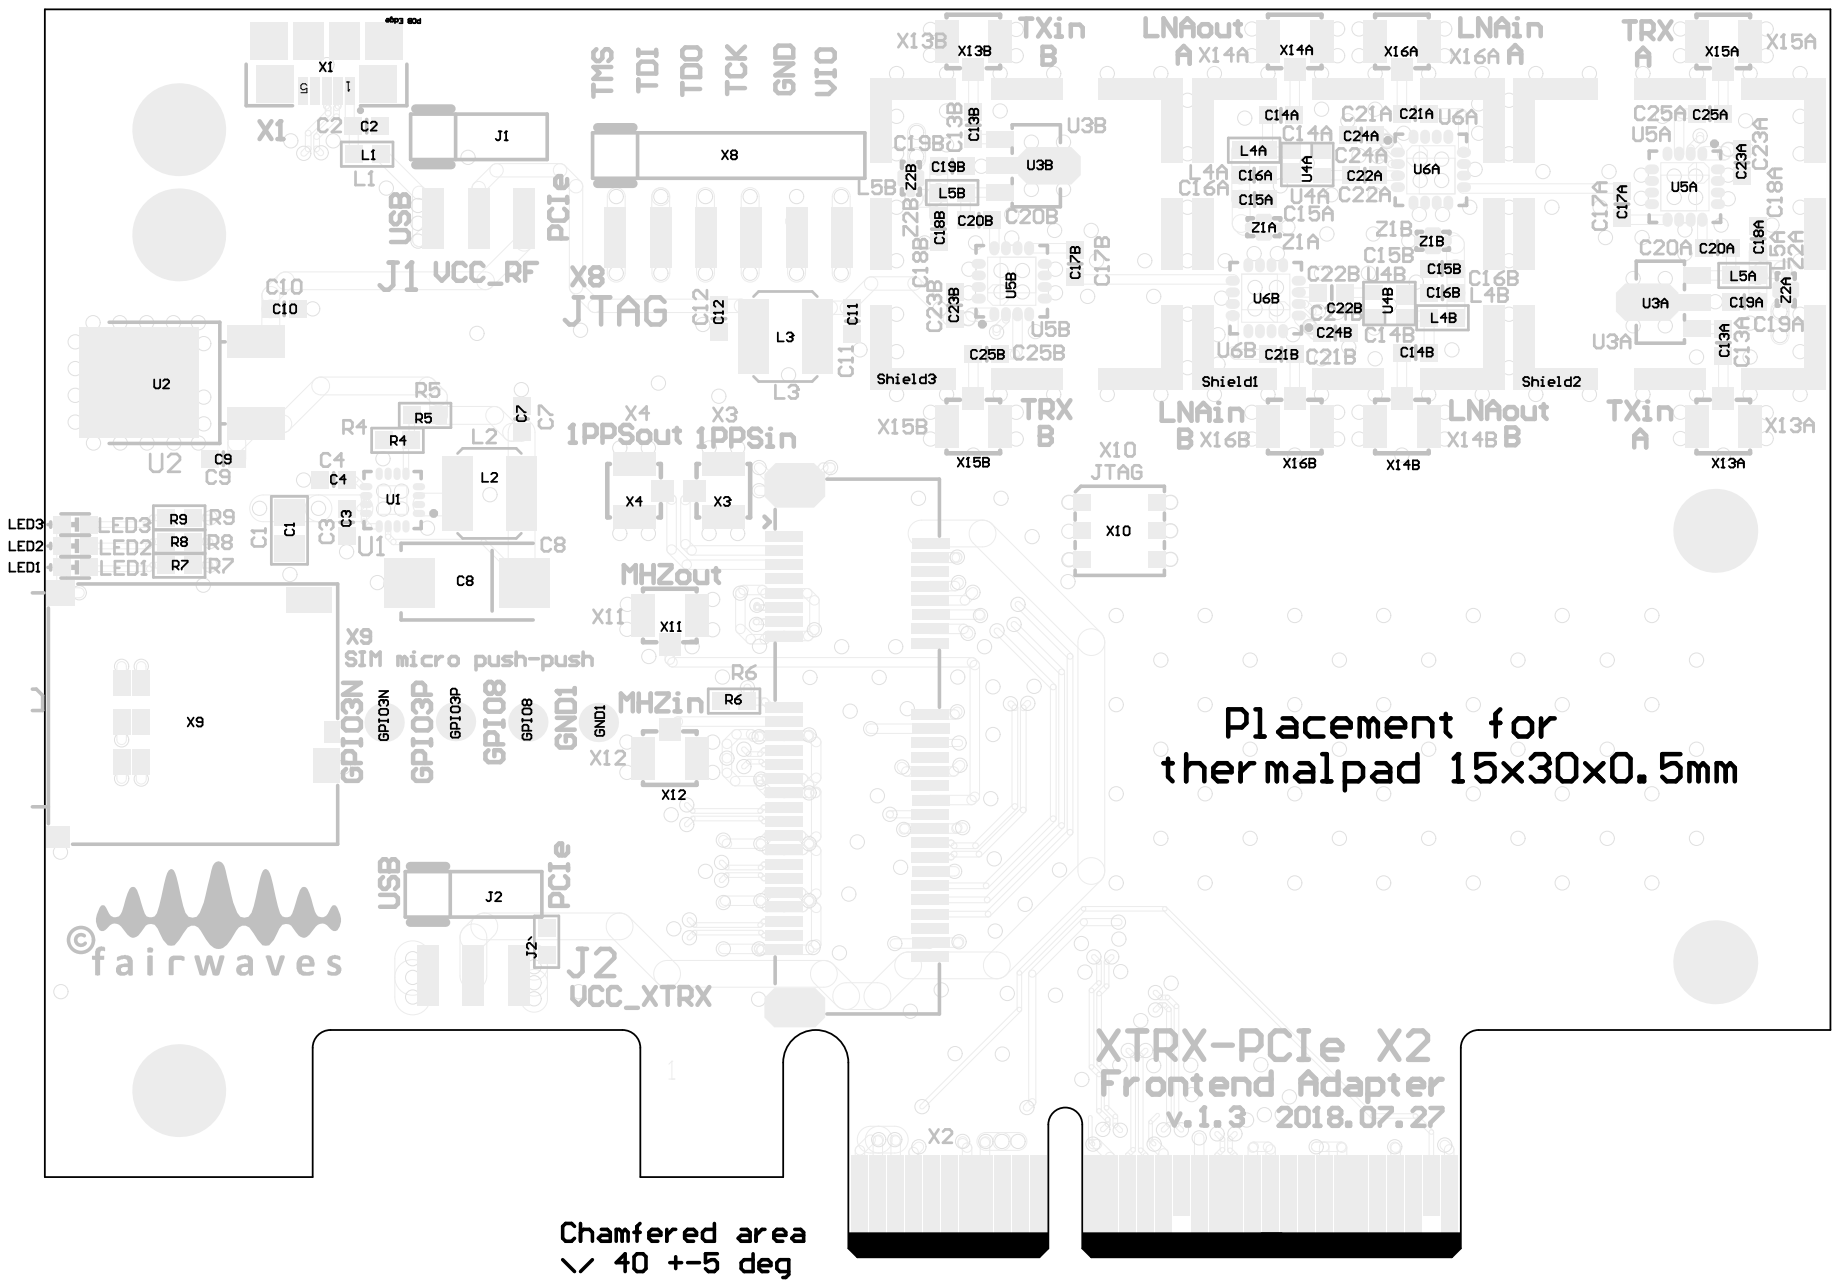
[picture p26: page 1]
