xtrx-sdr/xtrx-adapters/USB3/Project Outputs/USB3-PCIEv21_assembly(Var_1).PDF

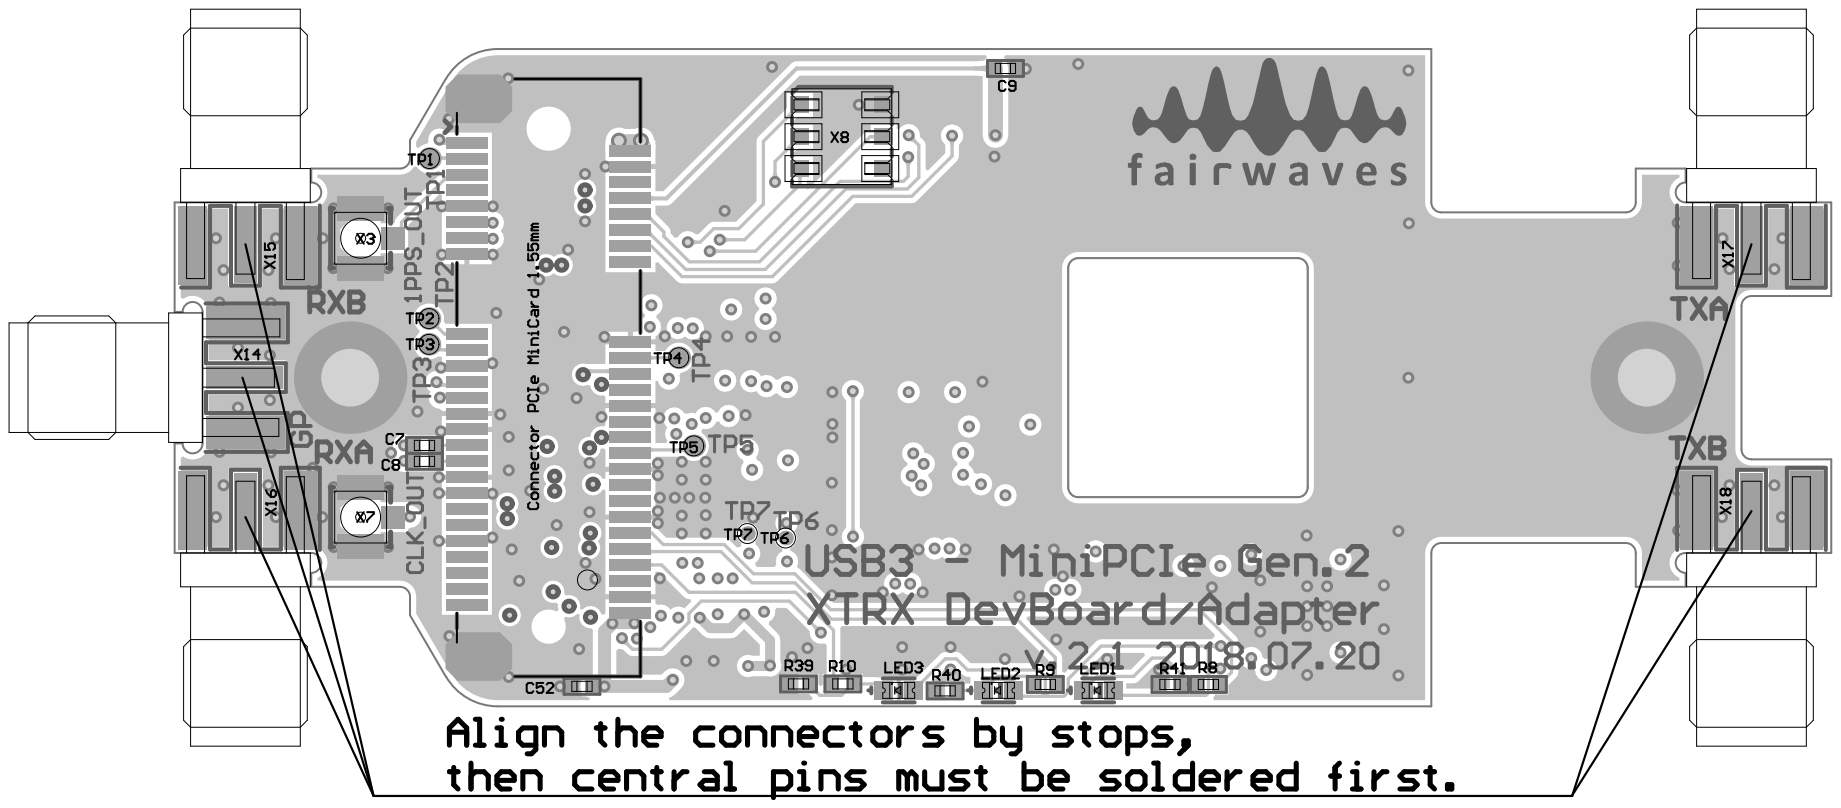
[picture p27: page 1]

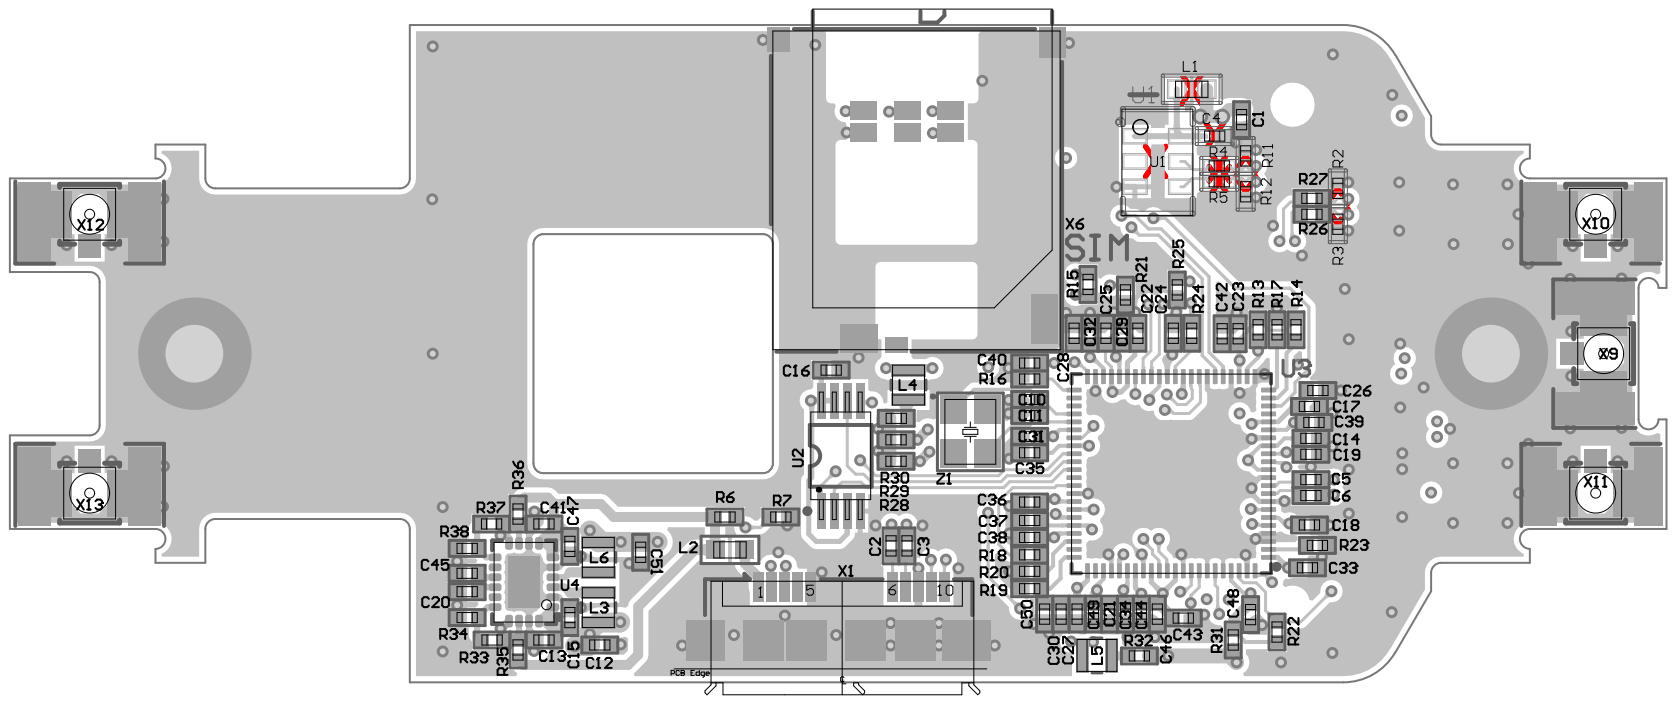
[picture p28: page 2]
