xtrx-sdr/xtrx-adapters/USB3/Models/frw-003_outbox_20180723_01_models&drawings/drawing/pdf/frw-003_Body_V11.pdf

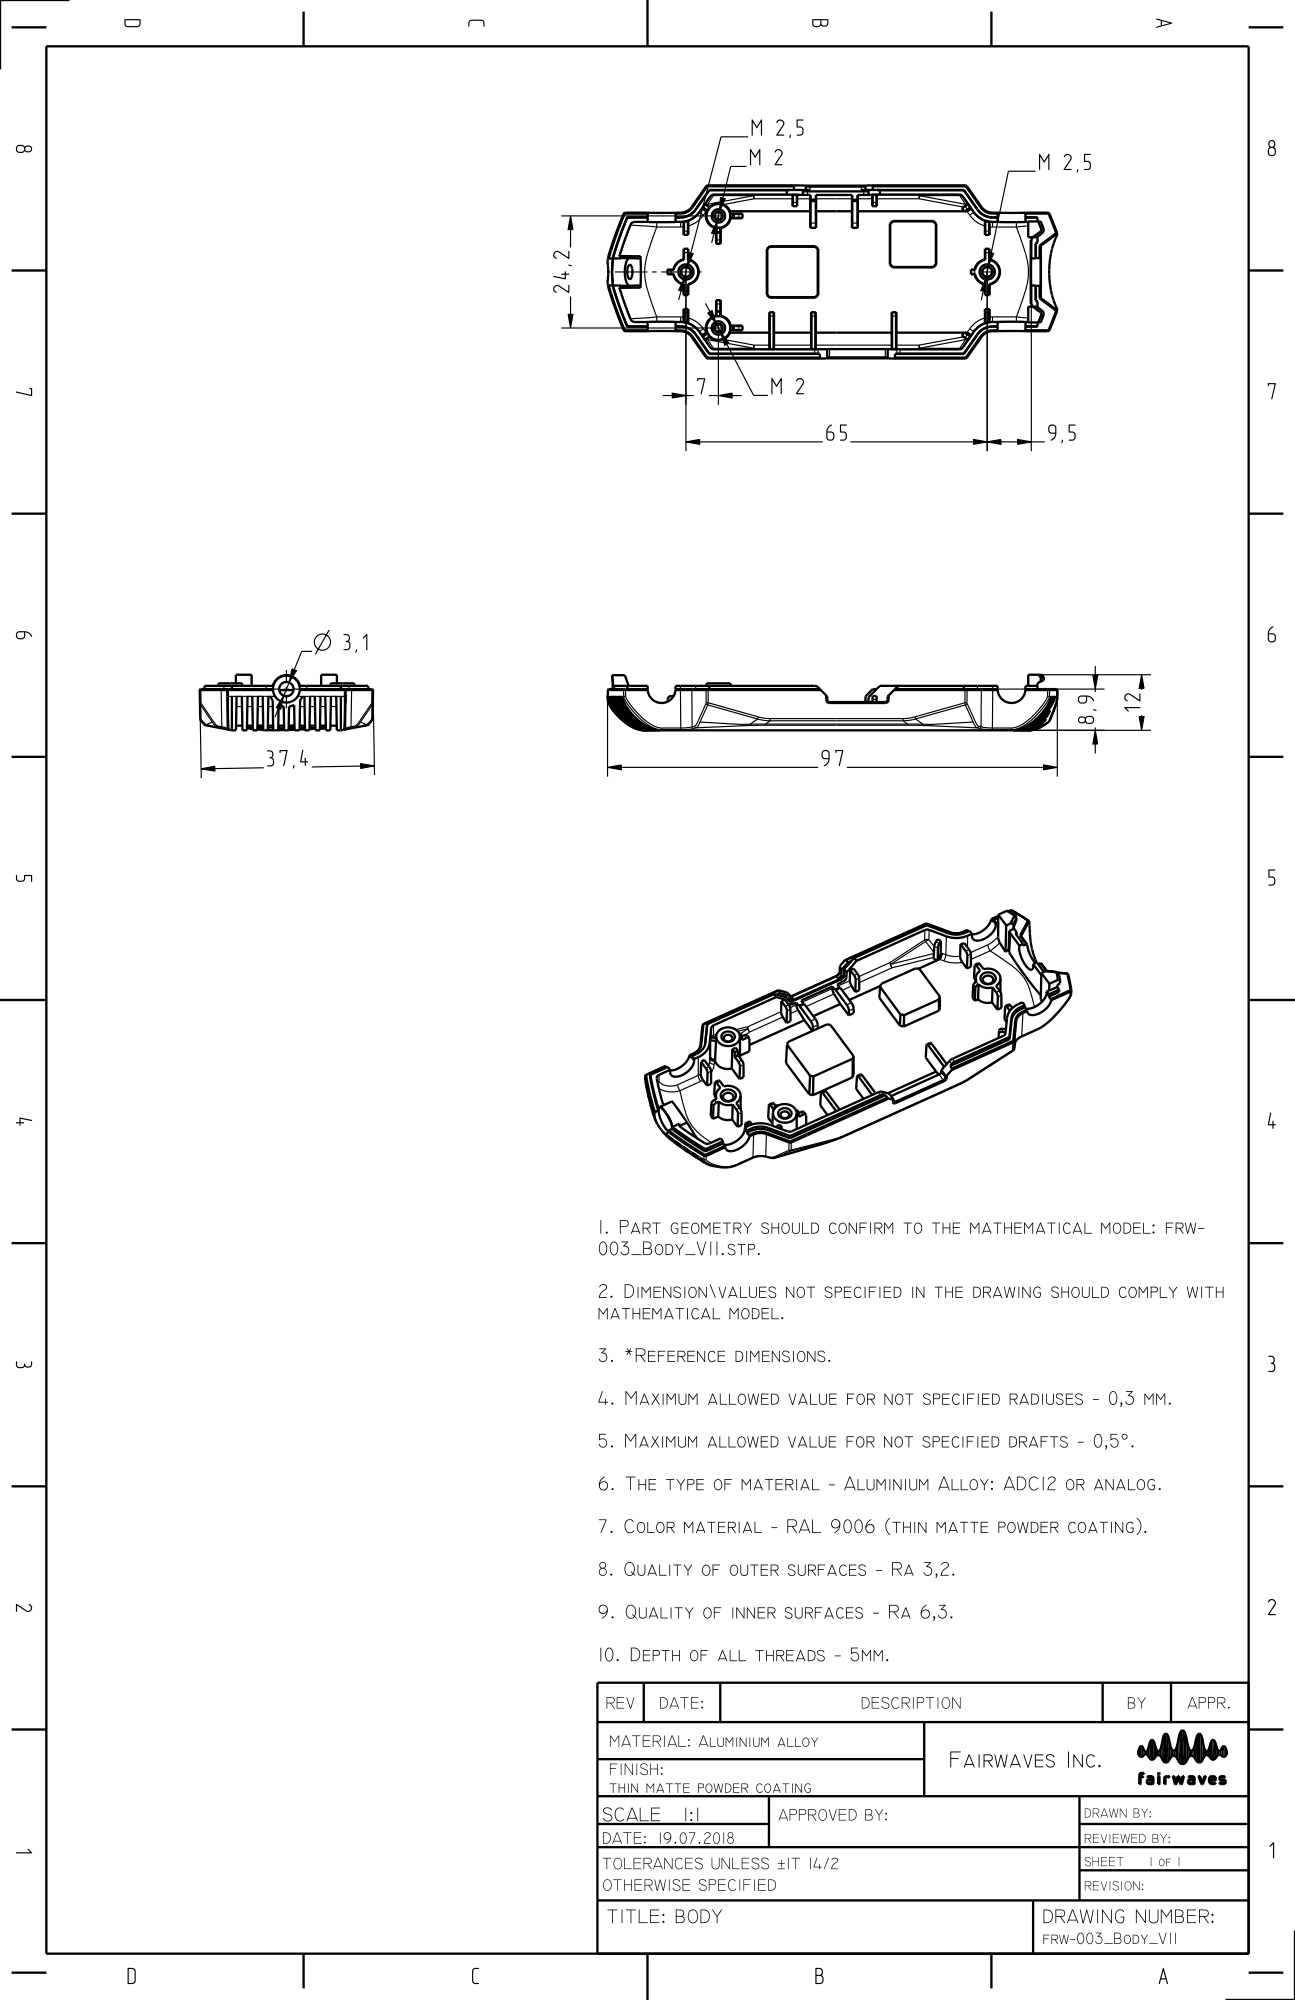
[picture p29: page 1]
