xtrx-sdr/xtrx-adapters/(list of files, drawings)

Other design files:
PCIex2 frontend/RF part v13.SchDoc
PCIex2 frontend/x4to1XTRXv13.PRJPCB
PCIex2 frontend/x4to1XTRXv13.SchDoc
USB3/USB3-PCIEv21.PRJPCB
USB3/USB3-PCIEv21.SchDoc
